chibarobotstuidonhk/MD2020/02-22/MD2020_bom.xlsx

Part | Value | Device | Package | Description | MPN | 製品詳細
C3 | 100n | C-EUC0603 | C0603 | CAPACITOR | CC0603KRX7R9BB104 | SMD CAP Ceramic 100nF-50V-10%-X7R
C4 | 100n | C-EUC0603 | C0603 | CAPACITOR | CC0603KRX7R9BB104 | SMD CAP Ceramic 100nF-50V-10%-X7R
C5 | 100n | C-EUC0603 | C0603 | CAPACITOR | CC0603KRX7R9BB104 | SMD CAP Ceramic 100nF-50V-10%-X7R
C6 | 10u | C-EUC1210 | C1210 | CAPACITOR | CL31A106KBHNNNE | 1206 10uF ±10% 50V X5R
C7 | 10u | C-EUC1210 | C1210 | CAPACITOR | CL31A106KBHNNNE | 1206 10uF ±10% 50V X5R
C8 | 100n/50V | C-EUC0603 | C0603 | CAPACITOR | CC0603KRX7R9BB104 | SMD CAP Ceramic 100nF-50V-10%-X7R
C9 | 100n | C-EUC0603 | C0603 | CAPACITOR | CC0603KRX7R9BB104 | SMD CAP Ceramic 100nF-50V-10%-X7R
C10 | 100n/25V | C-EUC0603 | C0603 | CAPACITOR | CC0603KRX7R9BB104 | SMD CAP Ceramic 100nF-50V-10%-X7R
C11 | 100n/25V | C-EUC0603 | C0603 | CAPACITOR | CC0603KRX7R9BB104 | SMD CAP Ceramic 100nF-50V-10%-X7R
C12 | 100n/50V | C-EUC0603 | C0603 | CAPACITOR | CC0603KRX7R9BB104 | SMD CAP Ceramic 100nF-50V-10%-X7R
C17 | 100n | C-EUC0603 | C0603 | CAPACITOR | CC0603KRX7R9BB104 | SMD CAP Ceramic 100nF-50V-10%-X7R
C18 | 100n | C-EUC0603 | C0603 | CAPACITOR | CC0603KRX7R9BB104 | SMD CAP Ceramic 100nF-50V-10%-X7R
C19 | 100n | C-EUC0603 | C0603 | CAPACITOR | CC0603KRX7R9BB104 | SMD CAP Ceramic 100nF-50V-10%-X7R
C21 | 1u | C-EUC0603 | C0603 | CAPACITOR | CC0603KRX7R8BB105 | SMD CAP Ceramic 1uF-25V-10%-X7R
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
R26 | 0.47R | R-EU_R0603 | R0603 | RESISTOR | 0603WAF470LT5E | 0603 0.47Ω ±1% 1/10W ±800ppm/℃
R27 | 10k | R-EU_R0603 | R0603 | RESISTOR | RC0603FR-0710KL | SMD RES 10K-1%-1/10W
R28 | 1k | R-EU_R0603 | R0603 | RESISTOR | RC0603FR-071KL | SMD RES 1K-1%-1/10W
R29 | 120R | R-EU_R0603 | R0603 | RESISTOR | RC0603JR-07120RL | SMD RES 120R-5%-1/10W;0603
R30 | 4k7 | R-EU_R0603 | R0603 | RESISTOR | RC0603FR-074K7L | SMD RES 4.7K-1%-1/10W;0603
R31 | 470R | R-EU_R0603 | R0603 | RESISTOR | RC0603JR-07470RL | SMD RES 470R-5%-1/10W;0603
R32 | 1k | R-EU_R0603 | R0603 | RESISTOR | RC0603FR-071KL | SMD RES 1K-1%-1/10W
R33 | 1k | R-EU_R0603 | R0603 | RESISTOR | RC0603FR-071KL | SMD RES 1K-1%-1/10W
R34 | 1k | R-EU_R0603 | R0603 | RESISTOR | RC0603FR-071KL | SMD RES 1K-1%-1/10W
R35 | 10k | R-EU_R0603 | R0603 | RESISTOR | RC0603FR-0710KL | SMD RES 10K-1%-1/10W
R109 | 10k | R-EU_R0603 | R0603 | RESISTOR | RC0603FR-0710KL | SMD RES 10K-1%-1/10W
R110 | 1k | R-EU_R0603 | R0603 | RESISTOR | RC0603FR-071KL | SMD RES 1K-1%-1/10W
R111 | 1k | R-EU_R0603 | R0603 | RESISTOR | RC0603FR-071KL | SMD RES 1K-1%-1/10W
U1 | STM32F103C8 | STM32F103C8 | LQFP48 | STMicroelectronics STM32F103C8 | STM32F103C8T6 | IC MCU 32BIT 64KB FLASH 48LQFP
U8 | MC34063AD | MC34063AD | SOIC8 |  | MC34063ADR2G | IC REG BUCK BOOST INV ADJ 8SOIC
U9 | MC34063AD | MC34063AD | SOIC8 |  | MC34063ADR2G | IC REG BUCK BOOST INV ADJ 8SOIC
X1 | 8MHZ | SMD-CRYSTAL-8MHZ--0.3%-150R(3P-3.6X1.3MM) | X3-SMD-3.6X1.3X0.8MM | 306010053 | CSTCE8M00G55-RO | SMD Crystal 8MHz-0.3%-150R
