chibarobotstuidonhk/MD2020/02-22/MD2020_02-22_bottom.pdf

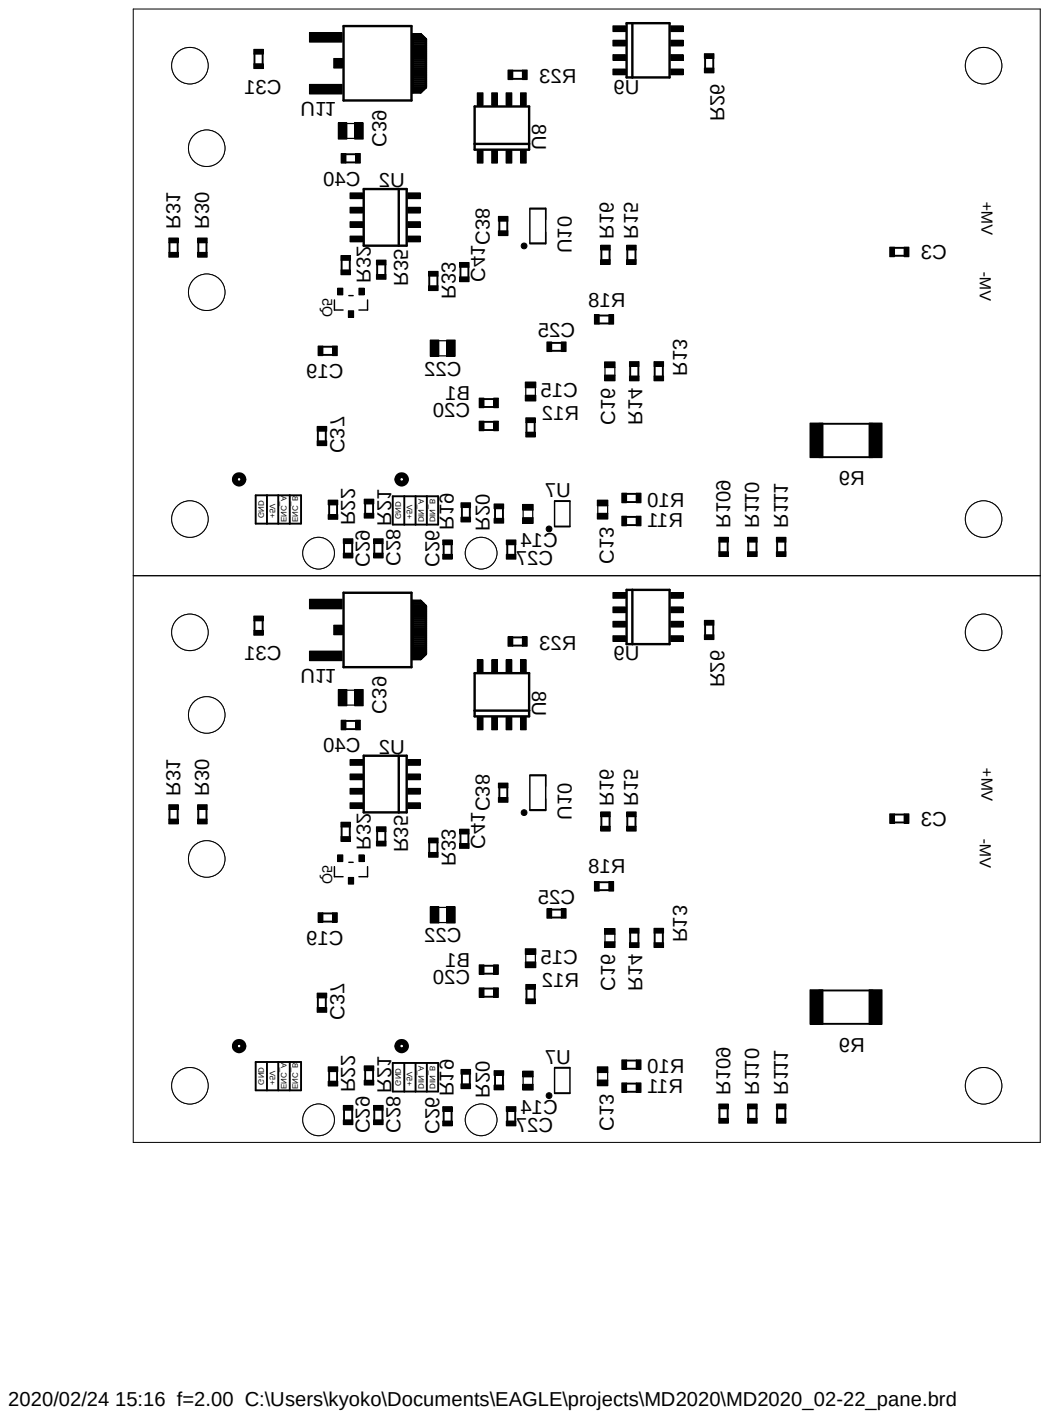
[picture p1: page 1]
