chibarobotstuidonhk/MD2020/02-22/MD2020_02-22_top.pdf

# C36 D¹ D² D³ D⁴

# D5 D⁶ D⁹ D¹⁰ D¹¹

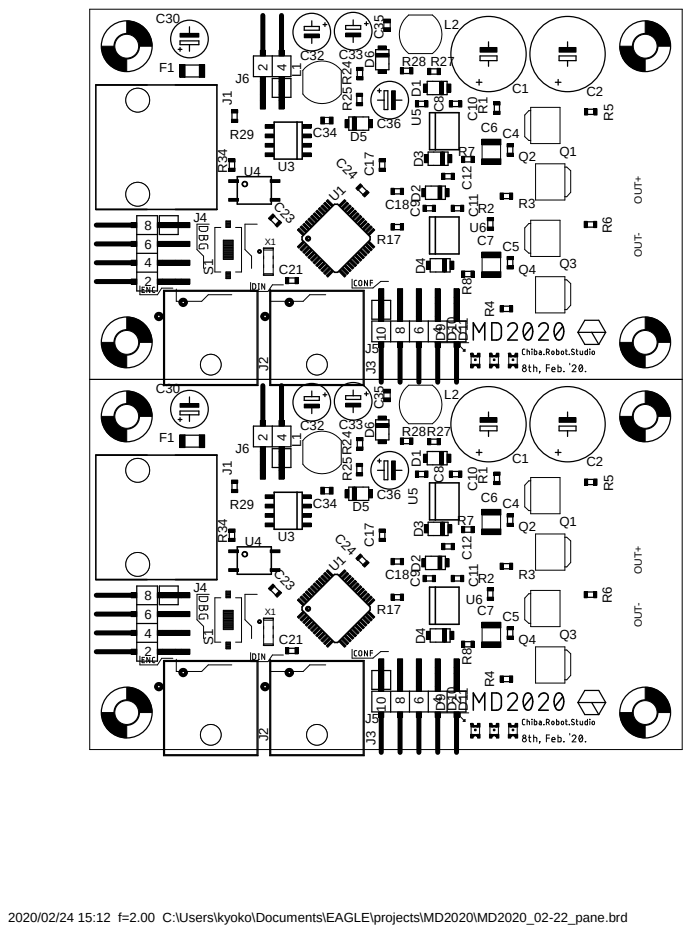
[picture p2: page 1]

R17 R²⁴ R²⁵

2020/02/24 15:12 f=2.00 C:\Users\kyoko\Documents\EAGLE\projects\MD2020\MD2020_02-22_pane.brd
