chibarobotstuidonhk/MD2020/02-22/MD2020_02-08.brd

## EAGLE design 02-22/MD2020_02-08.brd (2020-02-24)

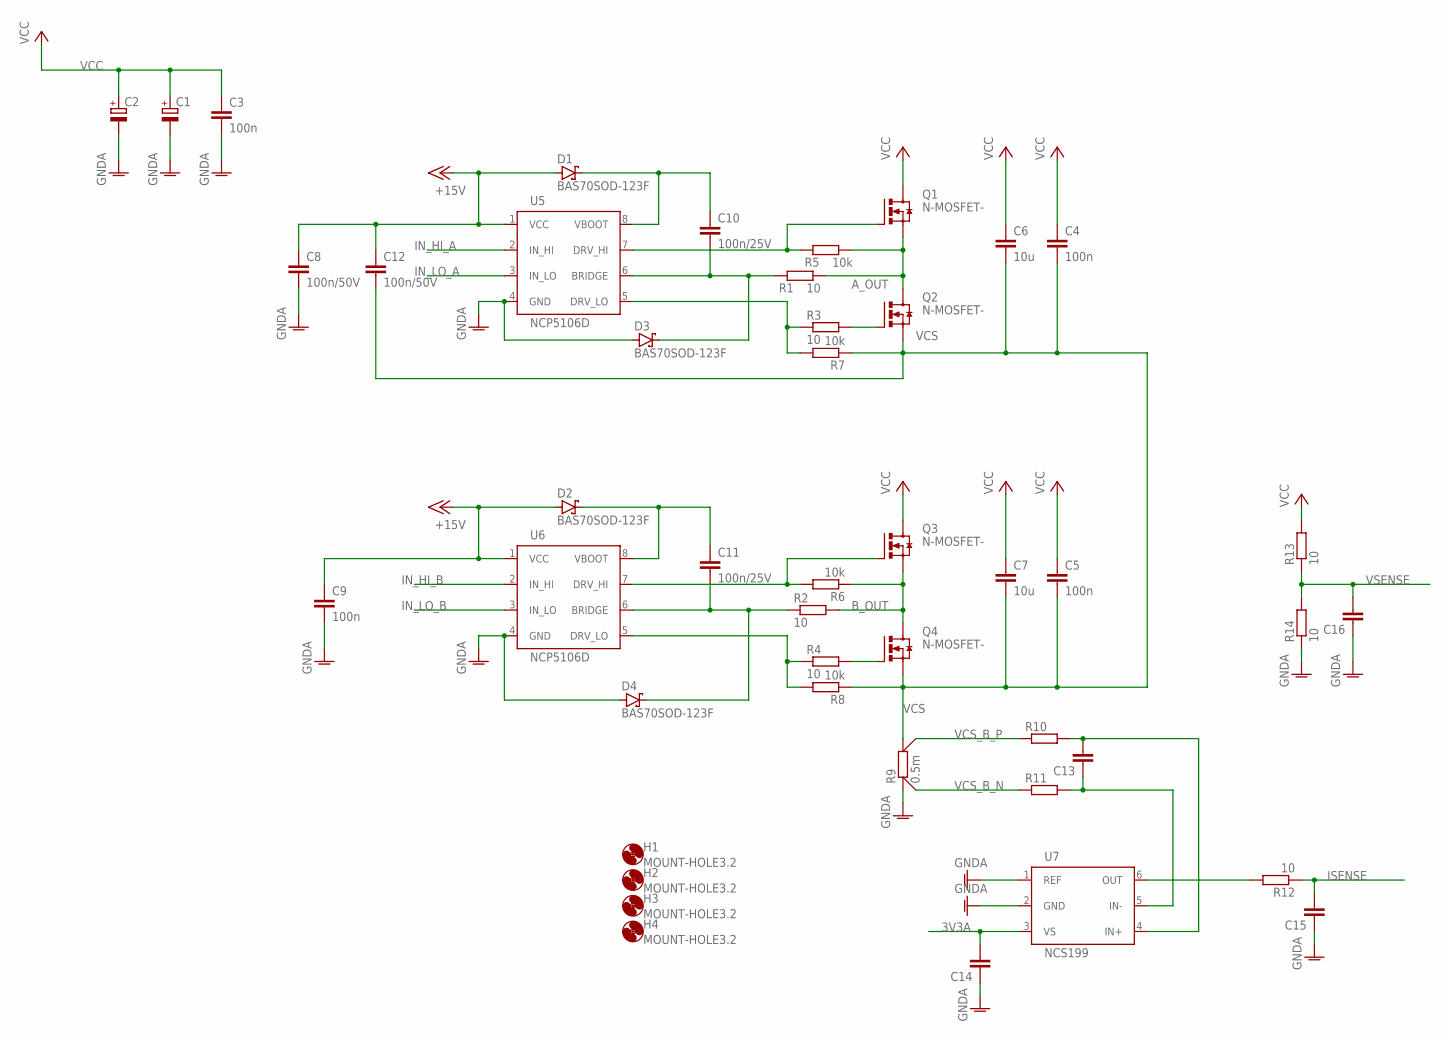
[picture p3: schematic MD2020_02-08.sch, sheet 1]

Parts:
C1, C2: CPOL-EUE5-10.5; E5-10,5
C3, C4, C5, C9: 100n; C0603; MPN CC0603KRX7R9BB104
C6, C7: 10u; C1210; MPN CL31A106KBHNNNE
C8, C12: 100n/50V; C0603; MPN CC0603KRX7R9BB104
C10, C11: 100n/25V; C0603; MPN CC0603KRX7R9BB104
C13, C14, C15, C16: C-EUC0603; C0603
D1, D2, D3, D4: BAS70SOD-123F; SOD123F; MPN PMEG4010EH,115
H1, H2, H3, H4: MOUNT-HOLE3.2; 3,2
Q1, Q2, Q3, Q4: N-MOSFET-; SOT669
R1, R2, R3, R4, R12, R13, R14: 10; R0603; MPN RC0603FR-0710RL
R5, R6, R7, R8: 10k; R0603; MPN RC0603FR-0710KL
R9: 0.5m; CSS2H-2512
R10, R11: R-EU_R0603; R0603
U5, U6: NCP5106D; SOIC127P600X175-8
U7: NCS199; SOT65P210X110-6

Connections:
3V3A: C14.2, U7.3 (VS); also elsewhere on the board
+15V: C8.1, C9.1, C12.1, D1.A, D2.A, U5.1 (VCC), U6.1 (VCC); also elsewhere on the board
A_OUT: Q1.1 (SOURCE), Q1.2 (SOURCE), Q1.3 (SOURCE), Q2.5 (DRAIN), R1.2, R5.1
B_OUT: Q3.1 (SOURCE), Q3.2 (SOURCE), Q3.3 (SOURCE), Q4.5 (DRAIN), R2.2, R6.1
GNDA: C1.-, C2.-, C3.2, C8.2, C9.2, C14.1, C15.1, C16.1, D3.A, D4.A, R9.1$1 (1), R9.1$2 (1), R14.1, U5.4 (GND), U6.4 (GND), U7.1 (REF), U7.2 (GND); also elsewhere on the board
IN_HI_A: U5.2 (IN_HI); also elsewhere on the board
IN_HI_B: U6.2 (IN_HI); also elsewhere on the board
IN_LO_A: U5.3 (IN_LO); also elsewhere on the board
IN_LO_B: U6.3 (IN_LO); also elsewhere on the board
ISENSE: C15.2, R12.1; also elsewhere on the board
unnamed: Q1.4 (GATE), R5.2, U5.7 (DRV_HI)
unnamed: Q3.4 (GATE), R6.2, U6.7 (DRV_HI)
unnamed: C10.2, D3.C, R1.1, U5.6 (BRIDGE)
unnamed: R4.1, R8.2, U6.5 (DRV_LO)
unnamed: R12.2, U7.6 (OUT)
unnamed: R3.1, R7.2, U5.5 (DRV_LO)
unnamed: C11.2, D4.C, R2.1, U6.6 (BRIDGE)
unnamed: C13.2, R10.2, U7.4 (IN+)
unnamed: C13.1, R11.2, U7.5 (IN-)
unnamed: Q2.4 (GATE), R3.2
unnamed: Q4.4 (GATE), R4.2
unnamed: C11.1, D2.C, U6.8 (VBOOT)
unnamed: C10.1, D1.C, U5.8 (VBOOT)
VCC: C1.+, C2.+, C3.1, C4.1, C5.1, C6.1, C7.1, Q1.5 (DRAIN), Q3.5 (DRAIN), R13.2; also elsewhere on the board
VCS: C4.2, C5.2, C6.2, C7.2, C12.2, Q2.1 (SOURCE), Q2.2 (SOURCE), Q2.3 (SOURCE), Q4.1 (SOURCE), Q4.2 (SOURCE), Q4.3 (SOURCE), R7.1, R8.1, R9.2$1 (2), R9.2$2 (2)
VCS_B_N: R9.1S, R11.1
VCS_B_P: R9.2S, R10.1
VSENSE: C16.2, R13.1, R14.2; also elsewhere on the board

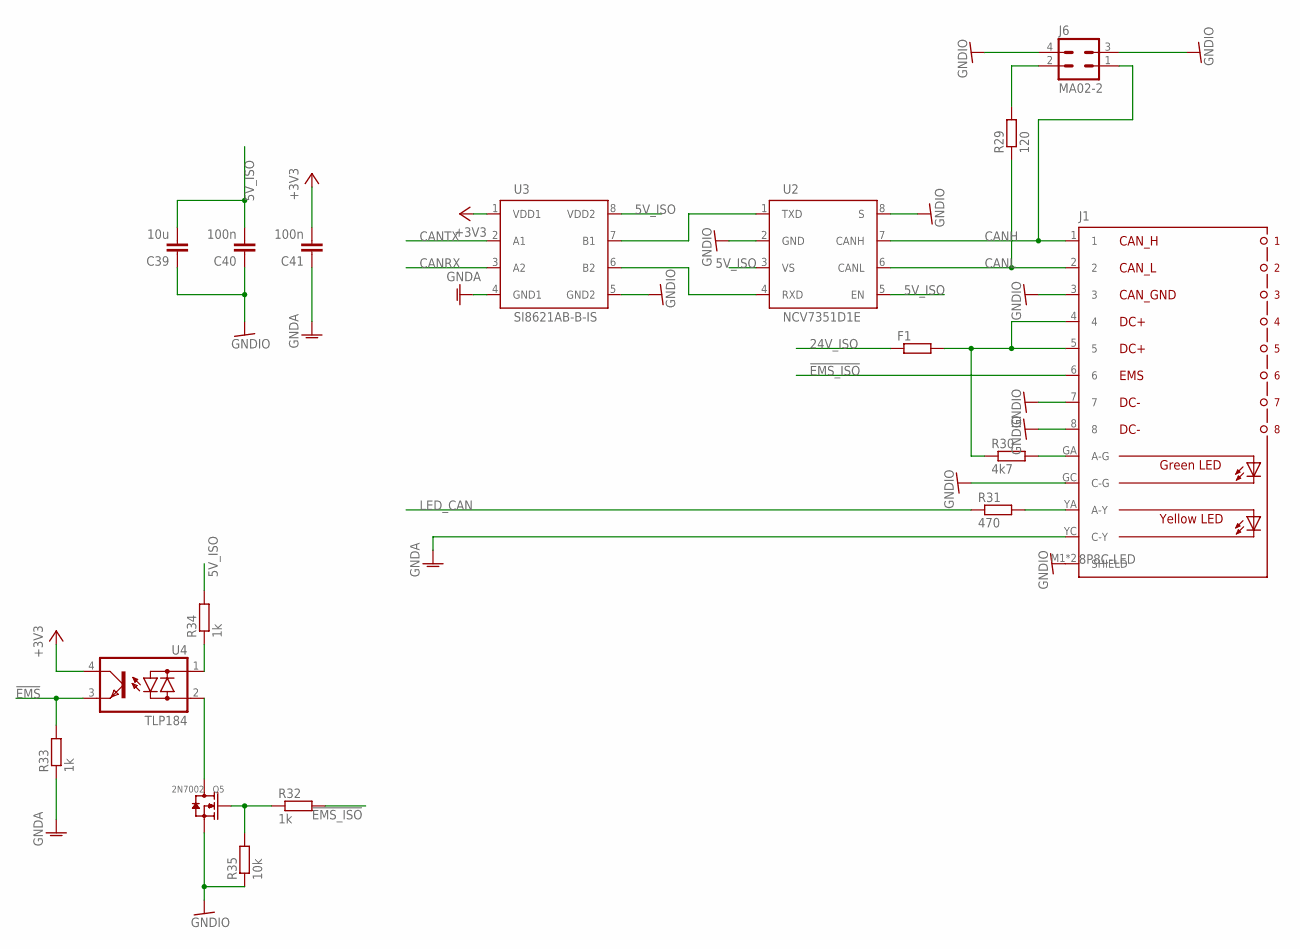
[picture p4: schematic MD2020_02-08.sch, sheet 2]

Parts:
C39: 10u; C0805; MPN CC0805ZKY5V6BB106
C40, C41: 100n; C0603; MPN CC0603KRX7R9BB104
F1: R-EU_R1206; R1206
J1: 8P8C-LED
J6: MA02-2; MA02-2W
Q5: 2N7002; SOT-23
R29: 120; R0603; MPN RC0603JR-07120RL
R30: 4k7; R0603; MPN RC0603FR-074K7L
R31: 470; R0603; MPN RC0603JR-07470RL
R32, R33, R34: 1k; R0603; MPN RC0603FR-071KL
R35: 10k; R0603; MPN RC0603FR-0710KL
U2: NCV7351D1E; SO08
U3: SI8621AB-B-IS; SO08
U4: TLP184; 11-4M1S

Connections:
5V_ISO: C39.2, C40.2, R34.2, U2.3 (VS), U2.5 (EN), U3.8 (VDD2); also elsewhere on the board
24V_ISO: F1.1; also elsewhere on the board
!EMS: R33.2, U4.3 (E); also elsewhere on the board
!EMS_ISO: J1.6, R32.2
+3V3: C41.2, U3.1 (VDD1), U4.4 (C); also elsewhere on the board
CANH: J1.1, J6.1, U2.7 (CANH)
CANL: J1.2, R29.1, U2.6 (CANL)
CANRX: U3.3 (A2); also elsewhere on the board
CANTX: U3.2 (A1); also elsewhere on the board
GNDA: C41.1, J1.YC (C-Y), R33.1, U3.4 (GND1); also elsewhere on the board
GNDIO: C39.1, C40.1, J1.3, J1.7, J1.8, J1.GC (C-G), J1.M1 (SHIELD), J1.M2 (SHIELD), J6.3, J6.4, Q5.2 (S), R35.1, U2.2 (GND), U2.8 (S), U3.5 (GND2); also elsewhere on the board
LED_CAN: R31.1; also elsewhere on the board
unnamed: F1.2, J1.4, J1.5, R30.1
unnamed: J6.2, R29.2
unnamed: J1.GA (A-G), R30.2
unnamed: J1.YA (A-Y), R31.2
unnamed: Q5.1 (G), R32.1, R35.2
unnamed: U2.1 (TXD), U3.7 (B1)
unnamed: U2.4 (RXD), U3.6 (B2)
unnamed: Q5.3 (D), U4.2 (AC2)
unnamed: R34.1, U4.1 (AC1)

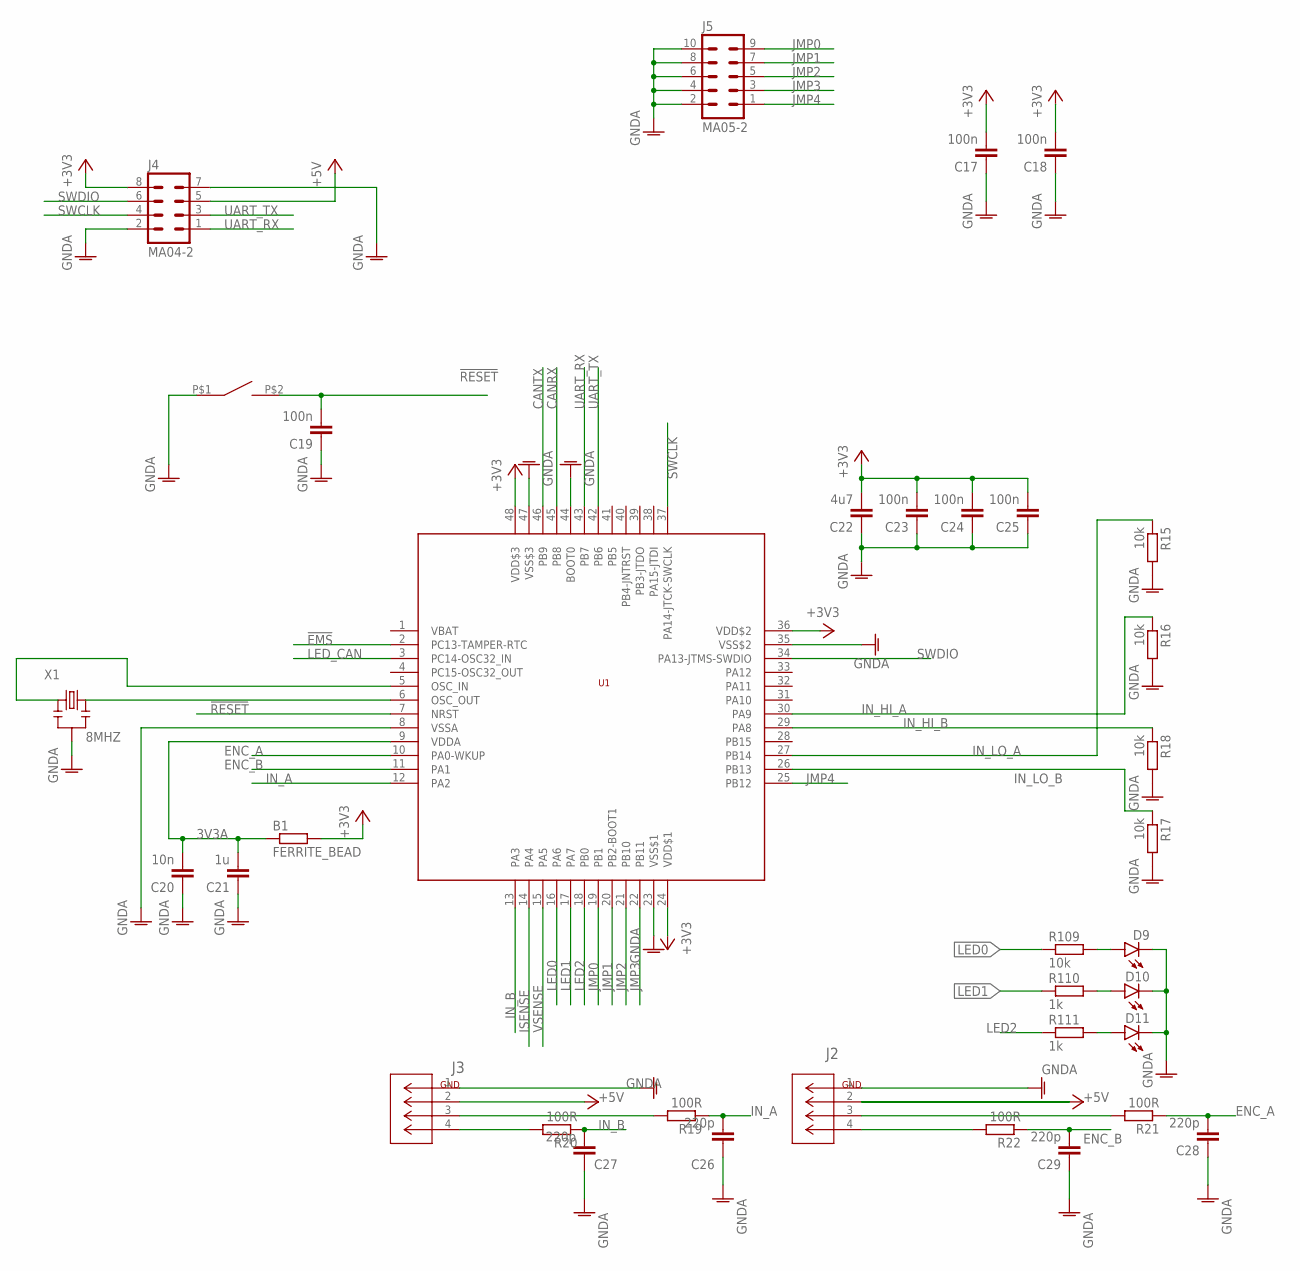
[picture p5: schematic MD2020_02-08.sch, sheet 3]

Parts:
B1: FERRITE_BEAD; R0603
C17, C18, C19, C23, C24, C25: 100n; C0603; MPN CC0603KRX7R9BB104
C20: 10n; C0603
C21: 1u; C0603; MPN CC0603KRX7R8BB105
C22: 4u7; C0805; MPN CC0603KRX5R6BB475
C26, C27, C28, C29: 220p; C0603; MPN CL10B221KB8NNNC
D9, D10, D11: LEDCHIPLED_0805; CHIPLED_0805
J2, J3: 1744426-4; CONN4_1744426-4
J4: MA04-2; MA04-2W
J5: MA05-2; MA05-2W
R15, R16, R17, R18, R109: 10k; R0603; MPN RC0603FR-0710KL
R19, R20, R21, R22: 100R; R0603; MPN RC0603JR-07100RL
R110, R111: 1k; R0603; MPN RC0603FR-071KL
S1: SWITCH_TACTILETOP; SWITCH_TACTILE_3X6
U1: STM32F103C8; LQFP48; MPN STM32F103C8T6
X1: 8MHZ; X3-SMD-3.6X1.3X0.8MM; MPN CSTCE8M00G55-RO

Connections:
3V3A: B1.1, C20.2, C21.2, U1.9 (VDDA); also elsewhere on the board
!EMS: U1.2 (PC13-TAMPER-RTC); also elsewhere on the board
!RESET: C19.2, S1.P$2 (2), U1.7 (NRST)
+3V3: B1.2, C17.2, C18.2, C22.2, C23.2, C24.2, C25.2, J4.8, U1.24 (VDD$1), U1.36 (VDD$2), U1.48 (VDD$3); also elsewhere on the board
+5V: J2.2, J3.2, J4.5; also elsewhere on the board
CANRX: U1.45 (PB8); also elsewhere on the board
CANTX: U1.46 (PB9); also elsewhere on the board
ENC_A: C28.2, R21.1, U1.10 (PA0-WKUP)
ENC_B: C29.2, R22.1, U1.11 (PA1)
GNDA: C17.1, C18.1, C19.1, C20.1, C21.1, C22.1, C23.1, C24.1, C25.1, C26.1, C27.1, C28.1, C29.1, D9.C, D10.C, D11.C, J2.1, J3.1, J4.2, J4.7, J5.2, J5.4, J5.6, J5.8, J5.10, R15.2, R16.2, R17.2, R18.2, S1.P$1 (1), U1.8 (VSSA), U1.23 (VSS$1), U1.35 (VSS$2), U1.44 (BOOT0), U1.47 (VSS$3), X1.2; also elsewhere on the board
IN_A: C26.2, R19.1, U1.12 (PA2)
IN_B: C27.2, R20.1, U1.13 (PA3)
IN_HI_A: R16.1, U1.30 (PA9); also elsewhere on the board
IN_HI_B: R18.1, U1.29 (PA8); also elsewhere on the board
IN_LO_A: R15.1, U1.27 (PB14); also elsewhere on the board
IN_LO_B: R17.1, U1.26 (PB13); also elsewhere on the board
ISENSE: U1.14 (PA4); also elsewhere on the board
JMP0: J5.9, U1.19 (PB1)
JMP1: J5.7, U1.20 (PB2-BOOT1)
JMP2: J5.5, U1.21 (PB10)
JMP3: J5.3, U1.22 (PB11)
JMP4: J5.1, U1.25 (PB12)
LED0: R109.1, U1.16 (PA6)
LED1: R110.1, U1.17 (PA7)
LED2: R111.1, U1.18 (PB0)
LED_CAN: U1.3 (PC14-OSC32_IN); also elsewhere on the board
unnamed: D10.A, R110.2
unnamed: D9.A, R109.2
unnamed: U1.6 (OSC_OUT), X1.3
unnamed: J2.4, R22.2
unnamed: J3.4, R20.2
unnamed: J2.3, R21.2
unnamed: J3.3, R19.2
unnamed: U1.5 (OSC_IN), X1.1
unnamed: D11.A, R111.2
SWCLK: J4.4, U1.37 (PA14-JTCK-SWCLK)
SWDIO: J4.6, U1.34 (PA13-JTMS-SWDIO)
UART_RX: J4.1, U1.43 (PB7)
UART_TX: J4.3, U1.42 (PB6)
VSENSE: U1.15 (PA5); also elsewhere on the board

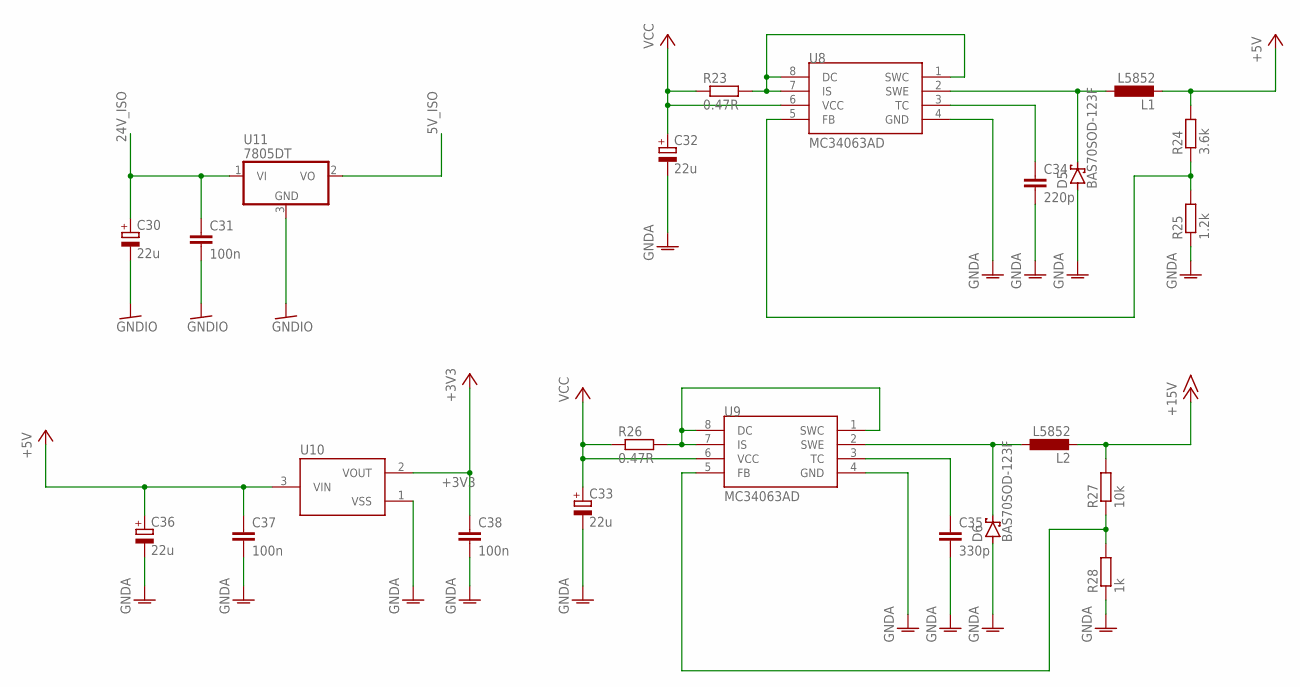
[picture p6: schematic MD2020_02-08.sch, sheet 4]

Parts:
C30, C36: 22u; E2,5-5
C31, C37, C38: 100n; C0603; MPN CC0603KRX7R9BB104
C32, C33: 22u; E2-5
C34: 220p; C0603; MPN CL10B221KB8NNNC
C35: 330p; C0603; MPN CL10B331KB8NNNC
D5, D6: BAS70SOD-123F; SOD123F; MPN PMEG4010EH,115
L1, L2: L5852
R23, R26: 0.47R; R0603; MPN 0603WAF470LT5E
R24: 3.6k; R0603; MPN RC0603JR-073K6L
R25: 1.2k; R0603; MPN RC0603JR-071K2L
R27: 10k; R0603; MPN RC0603FR-0710KL
R28: 1k; R0603; MPN RC0603FR-071KL
U8, U9: MC34063AD; SOIC8; MPN MC34063ADR2G
U10: XC6206; SOT95P240X110-3
U11: 7805DT; TO252

Connections:
5V_ISO: U11.2 (VO); also elsewhere on the board
24V_ISO: C30.+, C31.1, U11.1 (VI); also elsewhere on the board
+3V3: C38.1, U10.2 (VOUT); also elsewhere on the board
+5V: C36.+, C37.1, L1.P$2 (2), R24.2, U10.3 (VIN); also elsewhere on the board
+15V: L2.P$2 (2), R27.2; also elsewhere on the board
GNDA: C32.-, C33.-, C34.2, C35.2, C36.-, C37.2, C38.2, D5.A, D6.A, R25.1, R28.1, U8.4 (GND), U9.4 (GND), U10.1 (VSS); also elsewhere on the board
GNDIO: C30.-, C31.2, U11.3 (GND); also elsewhere on the board
unnamed: R23.2, U8.1 (SWC), U8.7 (IS), U8.8 (DC)
unnamed: D5.C, L1.P$1 (1), U8.2 (SWE)
unnamed: C34.1, U8.3 (TC)
unnamed: R24.1, R25.2, U8.5 (FB)
unnamed: R26.2, U9.1 (SWC), U9.7 (IS), U9.8 (DC)
unnamed: D6.C, L2.P$1 (1), U9.2 (SWE)
unnamed: C35.1, U9.3 (TC)
unnamed: R27.1, R28.2, U9.5 (FB)
VCC: C32.+, C33.+, R23.1, R26.1, U8.6 (VCC), U9.6 (VCC); also elsewhere on the board

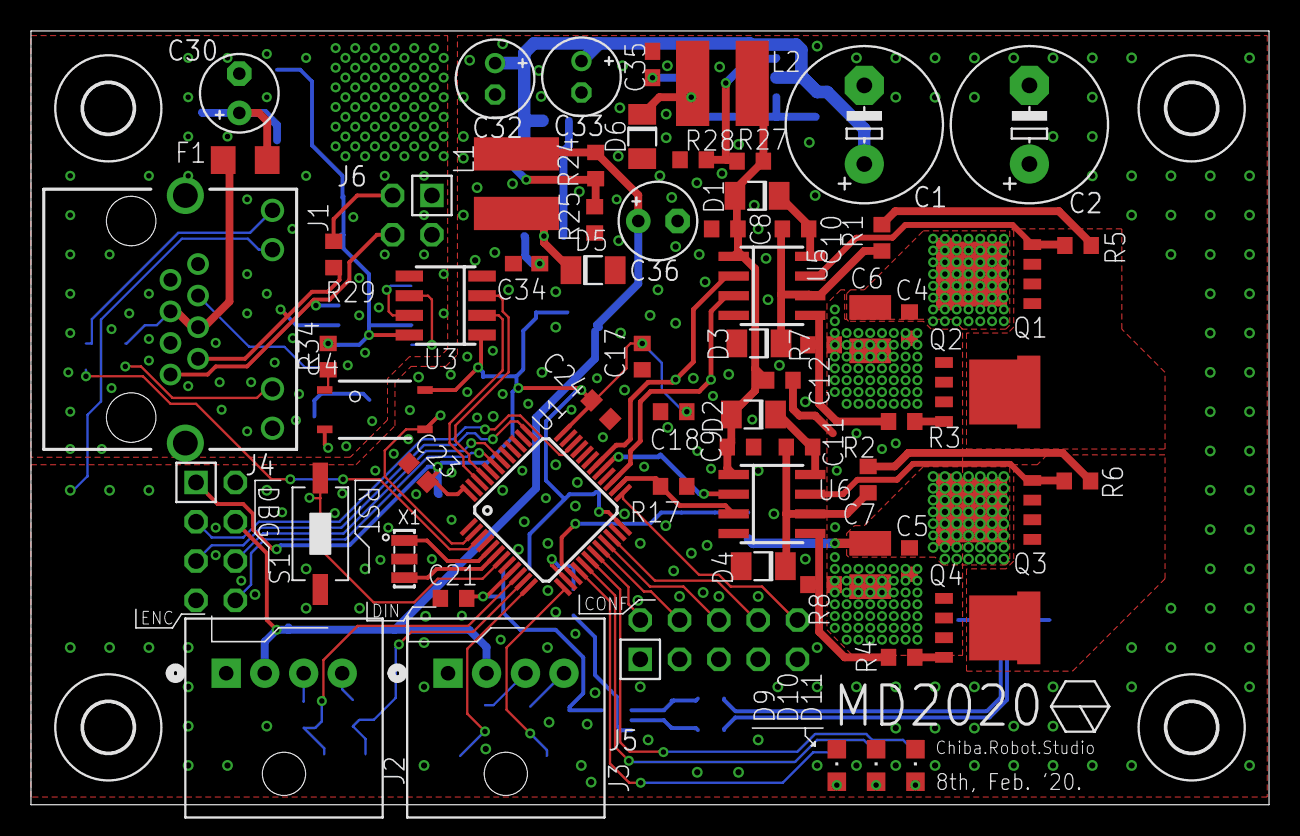
[picture p7: board MD2020_02-08.brd from above]

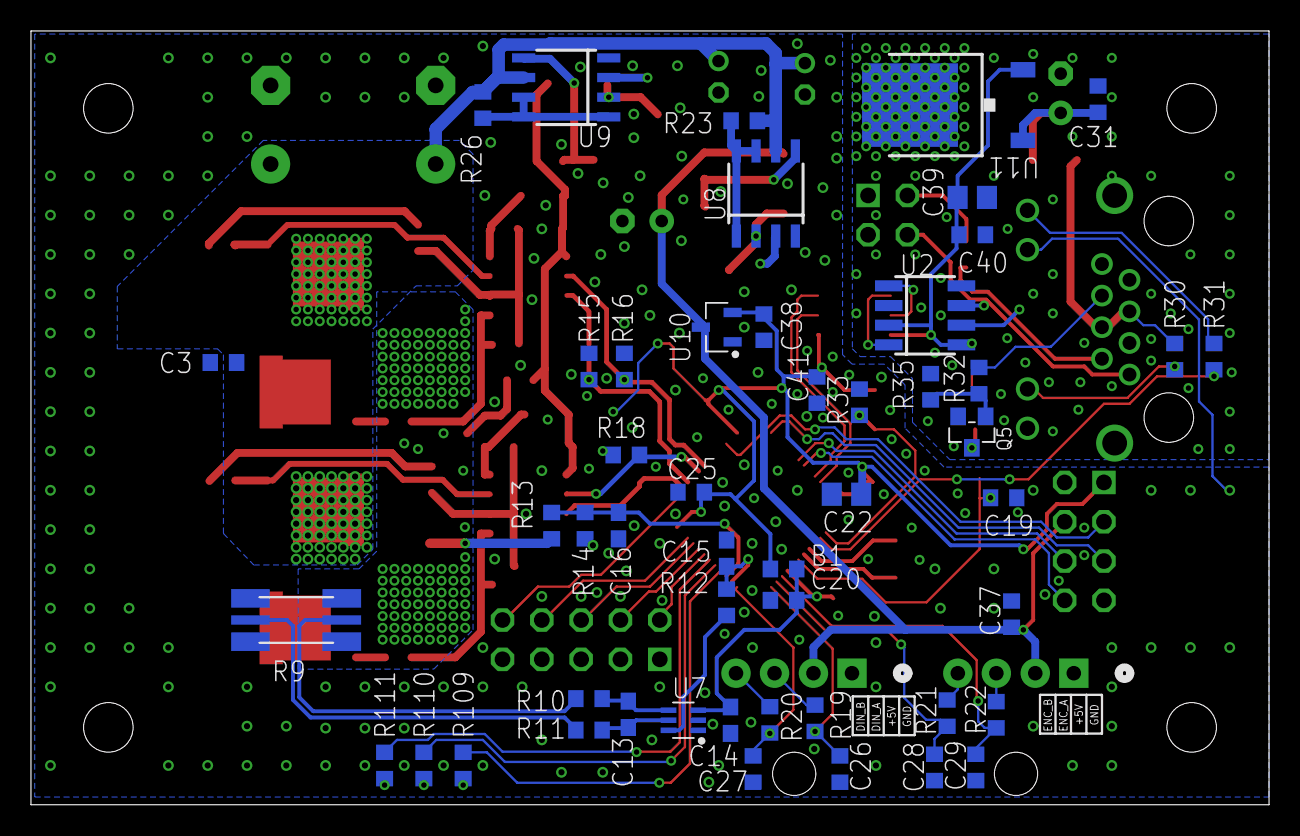
[picture p8: board MD2020_02-08.brd from below]

Board: 2 copper layers, 80.0 x 50.0 mm, 120 parts (50 on the bottom side), 83 nets.
