chibarobotstuidonhk/MD2020/02-22/MD2020_02-22_pane.brd

## EAGLE design 02-22/MD2020_02-22_pane.brd (2020-02-24)

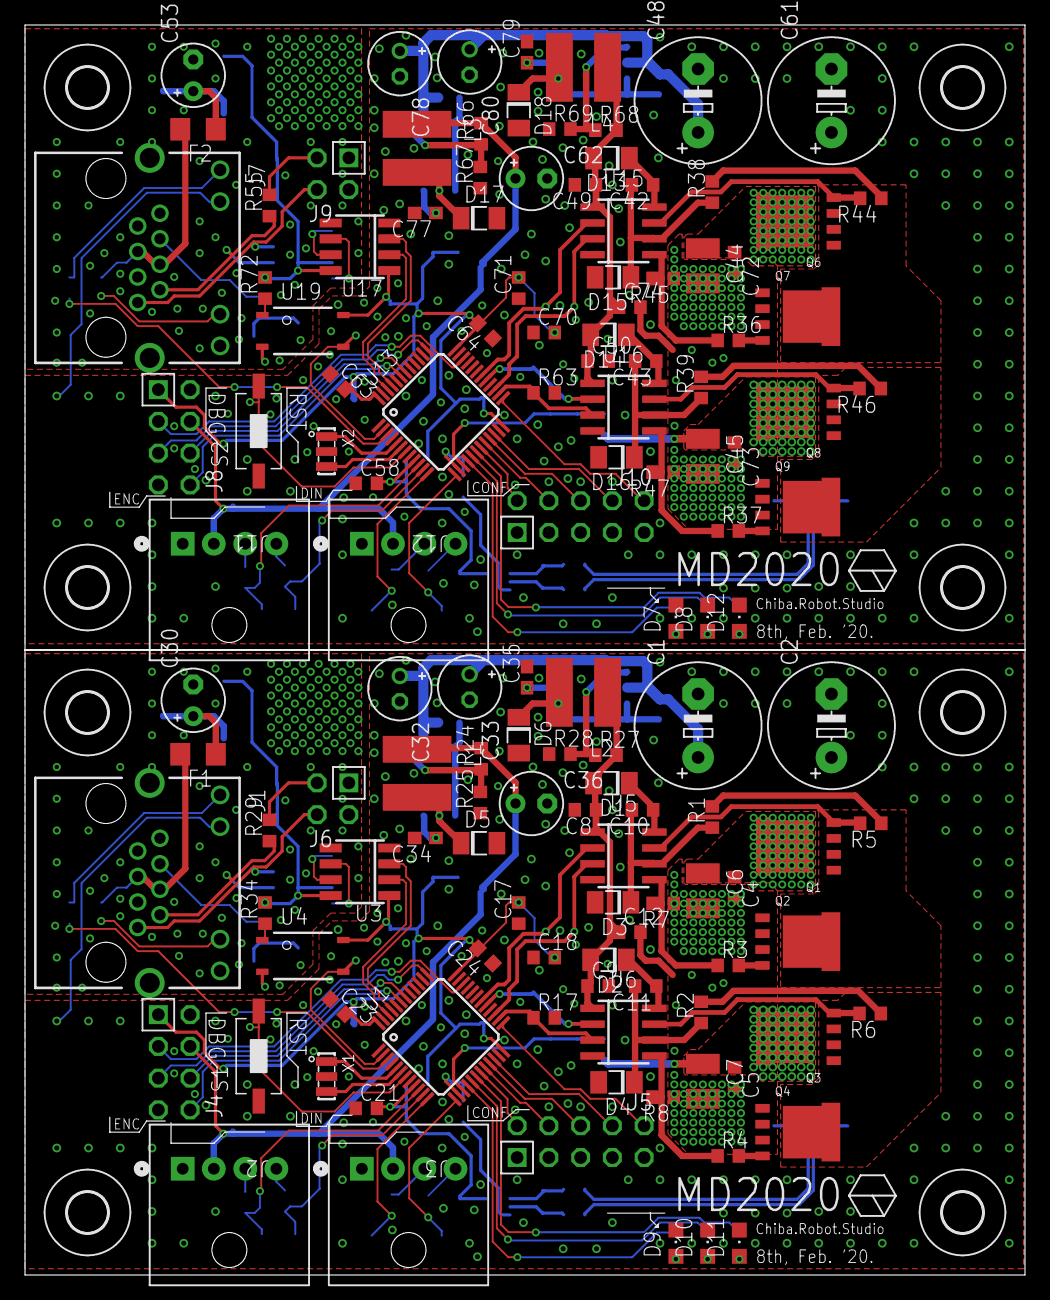
[picture p9: board MD2020_02-22_pane.brd from above]

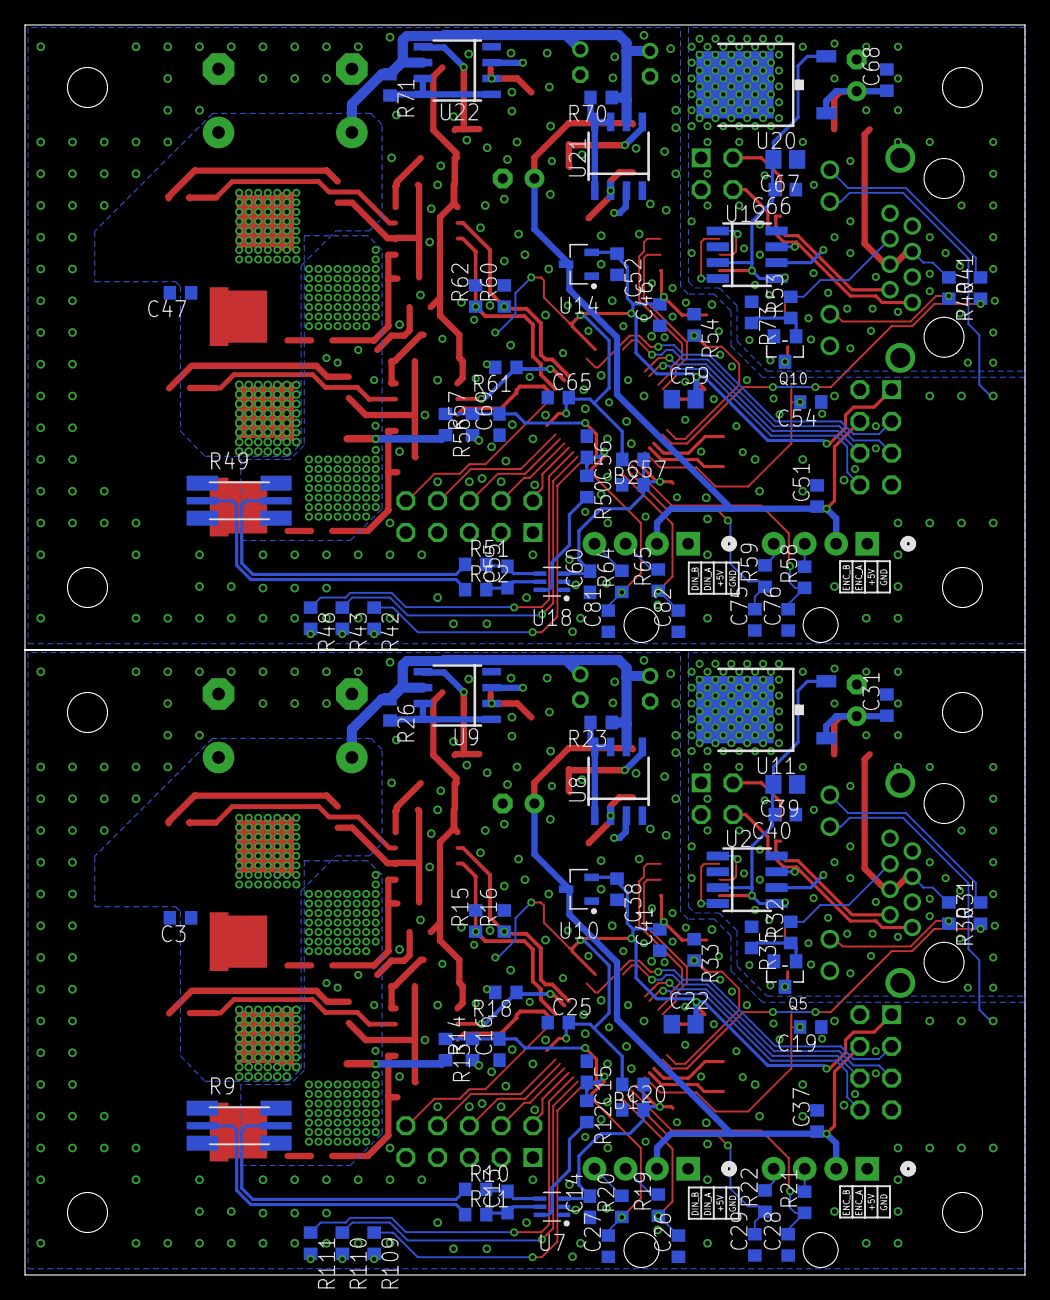
[picture p10: board MD2020_02-22_pane.brd from below]

Board: 2 copper layers, 80.0 x 100.0 mm, 240 parts (100 on the bottom side), 166 nets.

Parts:
B1, B2: FERRITE_BEAD; R0603
C1, C2, C48, C61: E5-10,5
C3, C4, C5, C9, C17, C18, C19, C23, C24, C25, C31, C37, C38, C40, C41, C46, C47, C50, C51, C52, C54, C63, C64, C65, C66, C68, C70, C71, C72, C73: 100n; C0603
C6, C7, C44, C45: 10u; C1210
C8, C12, C49, C74: 100n/50V; C0603
C10, C11, C42, C43: 100n/25V; C0603
C13, C14, C15, C16, C55, C56, C60, C69: C0603
C20, C57: 10n; C0603
C21, C58: 1u; C0603
C22, C59: 4u7; C0805
C26, C27, C28, C29, C34, C75, C76, C77, C81, C82: 220p; C0603
C30, C36, C53, C62: 22u; E2,5-5
C32, C33, C78, C80: 22u; E2-5
C35, C79: 330p; C0603
C39, C67: 10u; C0805
D1, D2, D3, D4, D5, D6, D13, D14, D15, D16, D17, D18: BAS70SOD-123F; SOD123F
D7, D8, D9, D10, D11, D12: CHIPLED_0805
F1, F2: R1206
H1, H2, H3, H4, H5, H6, H7, H8: MOUNT-HOLE3.2; 3,2
J1, J7: 8P8C-LED
J2, J3, J11, J12: 1744426-4; CONN4_1744426-4
J4, J8: MA04-2; MA04-2W
J5, J10: MA05-2; MA05-2W
J6, J9: MA02-2; MA02-2W
L1, L2, L3, L4: L5852
Q1, Q2, Q3, Q4, Q6, Q7, Q8, Q9: N-MOSFET-; SOT669
Q5, Q10: 2N7002; SOT-23
R1, R2, R3, R4, R12, R13, R14, R36, R37, R38, R39, R50, R56, R57: 10; R0603
R5, R6, R7, R8, R15, R16, R17, R18, R27, R35, R42, R44, R45, R46, R47, R60, R61, R62, R63, R68, R73, R109: 10k; R0603
R9, R49: 0.5m; CSS2H-2512
R10, R11, R51, R52: R0603
R19, R20, R21, R22, R58, R59, R64, R65: 100R; R0603
R23, R26, R70, R71: 0.47R; R0603
R24, R66: 3.6k; R0603
R25, R67: 1.2k; R0603
R28, R32, R33, R34, R43, R48, R53, R54, R69, R72, R110, R111: 1k; R0603
R29, R55: 120; R0603
R30, R40: 4k7; R0603
R31, R41: 470; R0603
S1, S2: SWITCH_TACTILETOP; SWITCH_TACTILE_3X6
U1, U13: STM32F103C8; LQFP48
U2, U12: NCV7351D1E; SO08
U3, U17: SI8621AB-B-IS; SO08
U4, U19: TLP184; 11-4M1S
U5, U6, U15, U16: NCP5106D; SOIC127P600X175-8
U7, U18: NCS199; SOT65P210X110-6
U8, U9, U21, U22: MC34063AD; SOIC8
U10, U14: XC6206; SOT95P240X110-3
U11, U20: 7805DT; TO252
X1, X2: 8MHZ; X3-SMD-3.6X1.3X0.8MM

Connections:
3V3A: B1.1, C14.2, C20.2, C21.2, U1.9, U7.3
3V3A1: B2.1, C57.2, C58.2, C60.2, U13.9, U18.3
5V_ISO: C39.2, C40.2, R34.2, U2.3, U2.5, U3.8, U11.2
5V_ISO1: C66.2, C67.2, R72.2, U12.3, U12.5, U17.8, U20.2
24V_ISO: C30.+, C31.1, F1.1, U11.1
24V_ISO1: C53.+, C68.1, F2.1, U20.1
!EMS: R33.2, U1.2, U4.3
!EMS1: R54.2, U13.2, U19.3
!EMS_ISO: J1.6, R32.2
!EMS_ISO1: J7.6, R53.2
!RESET: C19.2, S1.P$2, U1.7
!RESET1: C54.2, S2.P$2, U13.7
+3V1: B2.2, C46.2, C52.1, C59.2, C63.2, C64.2, C65.2, C70.2, C71.2, J8.8, U13.24, U13.36, U13.48, U14.2, U17.1, U19.4
+3V3: B1.2, C17.2, C18.2, C22.2, C23.2, C24.2, C25.2, C38.1, C41.2, J4.8, U1.24, U1.36, U1.48, U3.1, U4.4, U10.2
+5V: C36.+, C37.1, J2.2, J3.2, J4.5, L1.P$2, R24.2, U10.3
+5V1: C51.1, C62.+, J8.5, J11.2, J12.2, L3.P$2, R66.2, U14.3
+15V: C8.1, C9.1, C12.1, D1.A, D2.A, L2.P$2, R27.2, U5.1, U6.1
+15V1: C49.1, C50.1, C74.1, D13.A, D14.A, L4.P$2, R68.2, U15.1, U16.1
A_OUT: Q1.1, Q1.2, Q1.3, Q2.5, R1.2, R5.1
A_OUT1: Q6.1, Q6.2, Q6.3, Q7.5, R38.2, R44.1
B_OUT: Q3.1, Q3.2, Q3.3, Q4.5, R2.2, R6.1
B_OUT1: Q8.1, Q8.2, Q8.3, Q9.5, R39.2, R46.1
CANH: J1.1, J6.1, U2.7
CANH1: J7.1, J9.1, U12.7
CANL: J1.2, R29.1, U2.6
CANL1: J7.2, R55.1, U12.6
CANRX: U1.45, U3.3
CANRX1: U13.45, U17.3
CANTX: U1.46, U3.2
CANTX1: U13.46, U17.2
ENC_A: C28.2, R21.1, U1.10
ENC_A1: C76.2, R58.1, U13.10
ENC_B: C29.2, R22.1, U1.11
ENC_B1: C75.2, R59.1, U13.11
GNDA: C1.-, C2.-, C3.2, C8.2, C9.2, C14.1, C15.1, C16.1, C17.1, C18.1, C19.1, C20.1, C21.1, C22.1, C23.1, C24.1, C25.1, C26.1, C27.1, C28.1, C29.1, C32.-, C33.-, C34.2, C35.2, C36.-, C37.2, C38.2, C41.1, D3.A, D4.A, D5.A, D6.A, D9.C, D10.C, D11.C, J1.YC, J2.1, J3.1, J4.2, J4.7, J5.2, J5.4, J5.6, J5.8, J5.10, R9.1$1, R9.1$2, R14.1, R15.2, R16.2, R17.2, R18.2, R25.1, R28.1, R33.1, S1.P$1, U1.8, U1.23, U1.35, U1.44, U1.47, U3.4, U5.4, U6.4, U7.1, U7.2, U8.4, U9.4, U10.1, X1.2
GNDA1: C46.1, C47.2, C48.-, C49.2, C50.2, C51.2, C52.2, C54.1, C56.1, C57.1, C58.1, C59.1, C60.1, C61.-, C62.-, C63.1, C64.1, C65.1, C69.1, C70.1, C71.1, C75.1, C76.1, C77.2, C78.-, C79.2, C80.-, C81.1, C82.1, D7.C, D8.C, D12.C, D15.A, D16.A, D17.A, D18.A, J7.YC, J8.2, J8.7, J10.2, J10.4, J10.6, J10.8, J10.10, J11.1, J12.1, R49.1$1, R49.1$2, R54.1, R57.1, R60.2, R61.2, R62.2, R63.2, R67.1, R69.1, S2.P$1, U13.8, U13.23, U13.35, U13.44, U13.47, U14.1, U15.4, U16.4, U17.4, U18.1, U18.2, U21.4, U22.4, X2.2
GNDIO: C30.-, C31.2, C39.1, C40.1, J1.3, J1.7, J1.8, J1.GC, J1.M1, J1.M2, J6.3, J6.4, Q5.2, R35.1, U2.2, U2.8, U3.5, U11.3
GNDIO1: C53.-, C66.1, C67.1, C68.2, J7.3, J7.7, J7.8, J7.GC, J7.M1, J7.M2, J9.3, J9.4, Q10.2, R73.1, U12.2, U12.8, U17.5, U20.3
IN_A: C26.2, R19.1, U1.12
IN_A1: C82.2, R65.1, U13.12
IN_B: C27.2, R20.1, U1.13
IN_B1: C81.2, R64.1, U13.13
IN_HI_A: R16.1, U1.30, U5.2
IN_HI_A1: R60.1, U13.30, U15.2
IN_HI_B: R18.1, U1.29, U6.2
IN_HI_B1: R61.1, U13.29, U16.2
IN_LO_A: R15.1, U1.27, U5.3
IN_LO_A1: R62.1, U13.27, U15.3
IN_LO_B: R17.1, U1.26, U6.3
IN_LO_B1: R63.1, U13.26, U16.3
ISENSE: C15.2, R12.1, U1.14
ISENSE1: C56.2, R50.1, U13.14
JMP0: J5.9, U1.19
JMP1: J5.7, U1.20
JMP2: J5.5, U1.21
JMP3: J5.3, U1.22
JMP4: J5.1, U1.25
JMP5: J10.9, U13.19
JMP6: J10.7, U13.20
JMP7: J10.5, U13.21
JMP8: J10.3, U13.22
JMP9: J10.1, U13.25
LED0: R109.1, U1.16
LED1: R110.1, U1.17
LED2: R111.1, U1.18
LED3: R48.1, U13.18
LED4: R42.1, U13.16
LED5: R43.1, U13.17
LED_CAN: R31.1, U1.3
LED_CAN1: R41.1, U13.3
unnamed: Q1.4, R5.2, U5.7
unnamed: Q3.4, R6.2, U6.7
unnamed: D10.A, R110.2
unnamed: C10.2, D3.C, R1.1, U5.6
unnamed: R4.1, R8.2, U6.5
unnamed: R12.2, U7.6
unnamed: D9.A, R109.2
unnamed: F1.2, J1.4, J1.5, R30.1
unnamed: J6.2, R29.2
unnamed: U1.6, X1.3
unnamed: R3.1, R7.2, U5.5
unnamed: J2.4, R22.2
unnamed: R23.2, U8.1, U8.7, U8.8
unnamed: D5.C, L1.P$1, U8.2
unnamed: J3.4, R20.2
unnamed: J2.3, R21.2
unnamed: J3.3, R19.2
unnamed: J1.GA, R30.2
unnamed: U1.5, X1.1
unnamed: J1.YA, R31.2
unnamed: D11.A, R111.2
unnamed: Q5.1, R32.1, R35.2
unnamed: U2.1, U3.7
unnamed: C34.1, U8.3
unnamed: C11.2, D4.C, R2.1, U6.6
unnamed: R24.1, R25.2, U8.5
unnamed: U2.4, U3.6
unnamed: R26.2, U9.1, U9.7, U9.8
unnamed: D6.C, L2.P$1, U9.2
unnamed: Q5.3, U4.2
unnamed: R34.1, U4.1
unnamed: C35.1, U9.3
unnamed: R27.1, R28.2, U9.5
unnamed: Q7.4, R36.2
unnamed: Q9.4, R37.2
unnamed: C13.2, R10.2, U7.4
unnamed: C13.1, R11.2, U7.5
unnamed: C43.1, D14.C, U16.8
unnamed: C42.1, D13.C, U15.8
unnamed: R37.1, R47.2, U16.5
unnamed: Q6.4, R44.2, U15.7
unnamed: Q8.4, R46.2, U16.7
unnamed: D8.A, R43.2
unnamed: D7.A, R42.2
unnamed: U13.6, X2.3
unnamed: U13.5, X2.1
unnamed: R36.1, R45.2, U15.5
unnamed: F2.2, J7.4, J7.5, R40.1
unnamed: D12.A, R48.2
unnamed: U12.1, U17.7
unnamed: U12.4, U17.6
unnamed: R50.2, U18.6
unnamed: J7.GA, R40.2
unnamed: J7.YA, R41.2
unnamed: C55.2, R51.2, U18.4
unnamed: C55.1, R52.2, U18.5
unnamed: J9.2, R55.2
unnamed: J12.4, R64.2
unnamed: J12.3, R65.2
unnamed: J11.4, R59.2
unnamed: Q2.4, R3.2
unnamed: J11.3, R58.2
unnamed: C42.2, D15.C, R38.1, U15.6
unnamed: Q4.4, R4.2
unnamed: C43.2, D16.C, R39.1, U16.6
unnamed: R70.2, U21.1, U21.7, U21.8
unnamed: C11.1, D2.C, U6.8
unnamed: D17.C, L3.P$1, U21.2
unnamed: C77.1, U21.3
unnamed: R66.1, R67.2, U21.5
unnamed: R71.2, U22.1, U22.7, U22.8
unnamed: D18.C, L4.P$1, U22.2
unnamed: C10.1, D1.C, U5.8
unnamed: C79.1, U22.3
unnamed: R68.1, R69.2, U22.5
unnamed: Q10.1, R53.1, R73.2
unnamed: Q10.3, U19.2
unnamed: R72.1, U19.1
SWCLK: J4.4, U1.37
SWCLK1: J8.4, U13.37
SWDIO: J4.6, U1.34
SWDIO1: J8.6, U13.34
UART_RX: J4.1, U1.43
UART_RX1: J8.1, U13.43
UART_TX: J4.3, U1.42
UART_TX1: J8.3, U13.42
VCC: C1.+, C2.+, C3.1, C4.1, C5.1, C6.1, C7.1, C32.+, C33.+, Q1.5, Q3.5, R13.2, R23.1, R26.1, U8.6, U9.6
VCC1: C44.1, C45.1, C47.1, C48.+, C61.+, C72.1, C73.1, C78.+, C80.+, Q6.5, Q8.5, R56.2, R70.1, R71.1, U21.6, U22.6
VCS: C4.2, C5.2, C6.2, C7.2, C12.2, Q2.1, Q2.2, Q2.3, Q4.1, Q4.2, Q4.3, R7.1, R8.1, R9.2$1, R9.2$2
VCS1: C44.2, C45.2, C72.2, C73.2, C74.2, Q7.1, Q7.2, Q7.3, Q9.1, Q9.2, Q9.3, R45.1, R47.1, R49.2$1, R49.2$2
VCS_B_N: R9.1S, R11.1
VCS_B_N1: R49.1S, R52.1
VCS_B_P: R9.2S, R10.1
VCS_B_P1: R49.2S, R51.1
VSENSE: C16.2, R13.1, R14.2, U1.15
VSENSE1: C69.2, R56.1, R57.2, U13.15
