chibarobotstuidonhk/MD2020/(commit log)

2020-02-17 とりあえず色々修正した
    [MD2020_02-08.brd, MD2020_02-08.sch]
2020-02-24 少々修正
    [MD2020_02-08.brd, MD2020_02-08.sch, MD2020_02-22_pane.brd, MD2020_bom.xlsx]
